yagami-light7/2025_TI_electronic_source_A/(list of files, drawings)

Other design files:
hardware/ProPrj_buck-boost_2026-01-25.epro
hardware/ProPrj_STM32G474RET6_2026-01-30.epro
hardware/ProPrj_UCC21520隔离半桥模块_2026-01-25.epro
hardware/ProPrj_交流检测电路_2026-01-25.epro
hardware/ProPrj_直流采样模块_2026-01-25.epro
hardware/ProPrj_辅助电源模块_2026-01-25.epro
hardware/ProPrj_逆变电路（单相三相）_2026-01-25.epro
