yagami-light7/2025_TI_electronic_source_A/code/Users/1-MWL/MWL_Data_Utils/MWL_Data_Utils.h

#pragma once

#include "main.h"
#include <stdint.h>
#include <string.h>

#define PI  3.1415926535897932384626433832795f
#define PI2 6.283f
#define SIN_POINTS 512
#define SPWM_POINTS 500
#define SPWM_MID    13600
#define SPWM_MAX   SPWM_MID + 9860

/**
 * @brief          查表快速求cos值
 *
 * @param[in]      x: angle to be calculated
 *
 * @retval         对应角度的cos值
 */
#define fast_cos(x)                     fast_sin(1.5707963f - x);

/**
 * @brief       快速sin函数表格
 *
 */
const float sin_tab[SIN_POINTS] = {
        0, 0.012296f, 0.024589f, 0.036879f, 0.049164f, 0.061441f, 0.073708f, 0.085965f, 0.098208f, 0.11044f, 0.12265f,
        0.13484f, 0.14702f, 0.15917f, 0.17129f, 0.18339f, 0.19547f, 0.20751f, 0.21952f, 0.2315f, 0.24345f, 0.25535f,
        0.26722f, 0.27905f, 0.29084f, 0.30258f, 0.31427f, 0.32592f, 0.33752f, 0.34907f, 0.36057f, 0.37201f, 0.38339f,
        0.39472f, 0.40599f, 0.41719f, 0.42834f, 0.43941f, 0.45043f, 0.46137f, 0.47224f, 0.48305f, 0.49378f, 0.50443f,
        0.51501f, 0.52551f, 0.53593f, 0.54627f, 0.55653f, 0.5667f, 0.57679f, 0.58679f, 0.5967f, 0.60652f, 0.61625f,
        0.62589f, 0.63543f, 0.64488f, 0.65423f, 0.66348f, 0.67263f, 0.68167f, 0.69062f, 0.69946f, 0.70819f, 0.71682f,
        0.72534f, 0.73375f, 0.74205f, 0.75023f, 0.75831f, 0.76626f, 0.77411f, 0.78183f, 0.78944f, 0.79693f, 0.80429f,
        0.81154f, 0.81866f, 0.82566f, 0.83254f, 0.83928f, 0.84591f, 0.8524f, 0.85876f, 0.865f, 0.8711f, 0.87708f, 0.88292f,
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
9290,9401,9514,9627,9741,9855,9970,10085,10201,10318,10435,10553,10671,10789,10908,11028,
11147,11268,11388,11509,11630,11752,11874,11996,12118,12241,12364,12487,12610,12733,12857,12980,
13104,13228,13352,13476};

#ifdef __cplusplus
extern "C" {
#endif

/**
 * @brief          将uint8_t数组转化为float数组
 *
 * @param[in]      uint8_data   需要转化的uint8_t数组
 *                 float_data   转化后的float数组
 *                 num_floats   float数组元素个数
 *
 * @retval         none
 */
extern void uint8_to_float(uint8_t *uint8_data, float *float_data, int num_floats);

/**
 * @brief          查表快速求sin值
 *
 * @param[in]      theta: angle to be calculated
 *
 * @retval         对应角度的sin值
 */
extern float fast_sin(float theta);

#ifdef __cplusplus
}
#endif
