yagami-light7/2025_TI_electronic_source_A/(commit log)

2025-12-06 提交2025电赛代码
    [daplink.cfg, stlink.cfg]
2026-01-25 更新了硬件篇
    [ProPrj_UCC21520隔离半桥模块_2026-01-25.epro, ProPrj_buck-boost_2026-01-25.epro, ProPrj_交流检测电路_2026-01-25.epro, ProPrj_直流采样模块_2026-01-25.epro, ProPrj_辅助电源模块_2026-01-25.epro, ProPrj_逆变电路（单相三相）_2026-01-25.epro]
2026-01-30 添加主控工程
    [ProPrj_STM32G474RET6_2026-01-30.epro]
2026-01-30 删除了一些不必要的东西
