yagami-light7/2025_TI_electronic_source_A/(notices)

Notices in the files:
code/Core/Src/app_freertos.c:
Copyright (c) 2025 STMicroelectronics.
All rights reserved.
This software is licensed under terms that can be found in the LICENSE file
readme.md:
License: CC BY-NC-SA 4.0
